gemarcano/soil_power_sensor/drawings/current.png

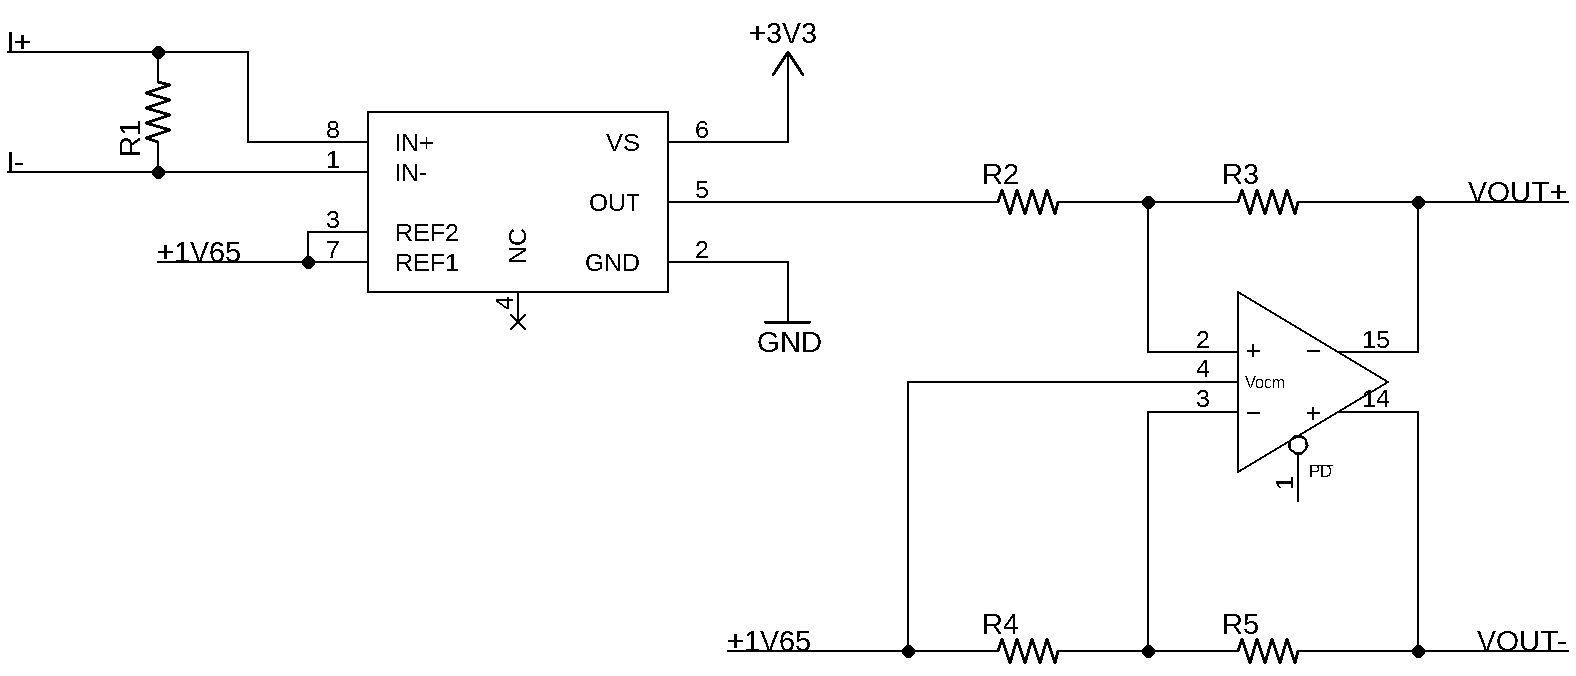
drawings/current.png
