gemarcano/soil_power_sensor/drawings/voltage.png

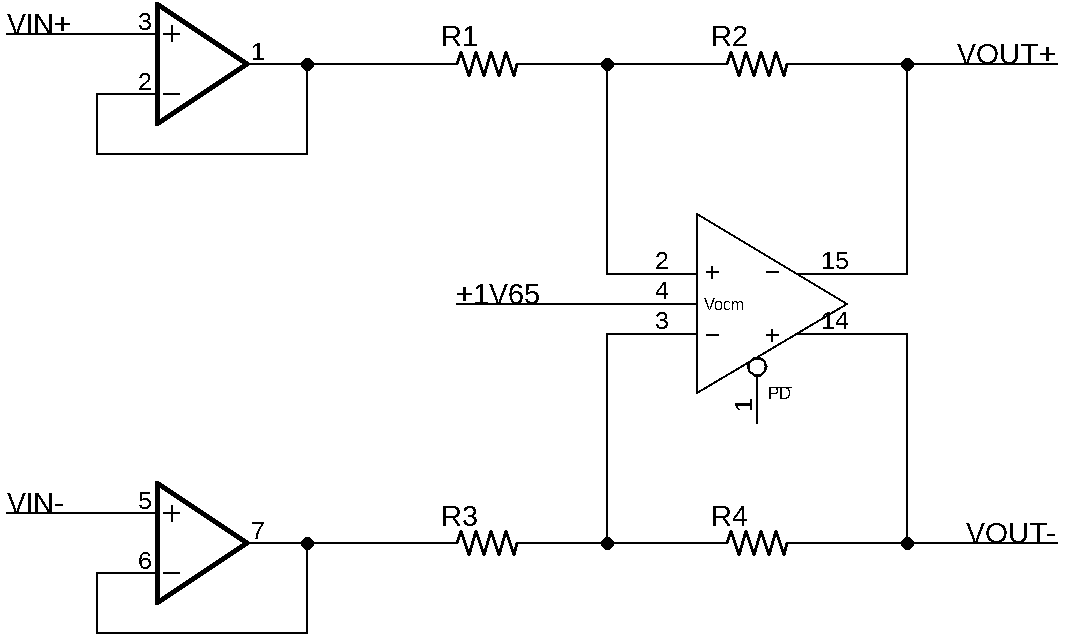
drawings/voltage.png
