gemarcano/soil_power_sensor/CHANGELOG.md

# Changelog

All notable changes to this project will be documented in this file.

The format is based on [Keep a Changelog](https://keepachangelog.com/en/1.0.0/), and this project adheres to [Semantic Versioning](https://semver.org/spec/v2.0.0.html).

## [Unreleased]

## [2.0.0-a.6] - 2023-05-10

### Schematic

- Updated current gain resistors

## [2.0.0-a.5] - 2023-05-02

### Schematic

- Removed buffer on negative rail and replaced MAX9944 with 
- Added values to parts missing VALUE text
- Renumbered all parts
- Remove power test points
- Added MPN to all passive components

### Board

- Iterate on board design
- Added UC Santa Cruz Logo
- Removed tValues
- Generated gerber files
- Updated low pass filter capacitance values
- Replaced 100nF capacitors with 0.1uF
- Replaced 250k resistors to 249K based on availability
- Replaced 0804 footprints with 0603

### Library

- Added MAX9943 device
- Added prefix for -3V3
- Updated LM27751 footprint
- Updated MAX9943 footprints

### Other

- Added source files for logos

## [2.0.0-a.4] - 2023-04-26

### Schematic

- Fixed duplicated naming for NRST net between STM32 and ESP32
- Fixed name of FSA2466 symbol
- Renamed differential pair nets to allow for differential pair routing
- Replaced Vcc on STM32 JTAG with +3V3

- Added experiment drawings

### Library

- Updated MAX9944 footprint
- Updated AAA55 Footprint

### Board

- Created initial layout for board

## [2.0.0-a.3] - 2023-04-11

### Schematic

- Removed jumper for 4th AAA battery cell
- Added document title and revision to frames
- Added TVS diode for both USB signal channels
- Fixed in-situ load connections
- Replaced FDA LTC6362 with THS4532IPW
- Moved multiplexer to analog signal side to reduce the number of ADCs as a cost saving measure
- Replaced low current main LDO TPS7A2033 with 1A TLV1117LV

- Replaced REF1933 with REF2033 due to availability
- Replaced TPS60403 with LM27761 due to availability

- Connected ESP32 EN pin to STM32 PA9 pin
- Connected STM32 PC0 to THS4532 PD pin
- Connected STM32 PC1 to EN on REF2033 and LM27761

### Library

- Verified footprints of all devices and fixed where applicable
- Added devices to Soil Power Sensor Library
	- TPD2E2U06DCKR
	- THS4532IPW
	- REF2033
	- LM27761
- Removed devices from Soil Power Sensor Library
	- MAX9918
	- LTC6362
	- STM32 Devices
	- Random oscillators
- Moved Wio-E5 to Soil Power Sensor library
- Defined attributes in CONTRIBUTING.md for efficient BOM generation

## [2.0.0-a.2] - 2023-03-14

### Added

- Added in-situ Rload
- Added connection for TEROS-12
- Added JTAG connection for STM32
- Added voltage monitoring circuit
- Added test points
- Added LP filter on signals leading to ADC
- Added FSA2466UMX to library
- Added Wifi Module (ESP32-C3)
- Added ESP32-C3-MINI-1-N4 to library
- Added TLV1117LV33DCYR to library
- Added battery with selectables jumpers
- Added AAA55
- Added Wio E5 and USB
- Added device MI0805K601R-10
- Added device MODULE_LORA_E5
- Added LT234XD-R device

### Fixed

- Fixed voltage and current connectors
- Fixed ADC interface with mux

### Changed

- Updated JTAG connector for ESP32
- Updated TLV1117LV33DCYR in library
- Moved power to seperate sheet

### Removed

None

## [2.0.0-a.1] - 2023-02-02

Initial design for Soil Power Sensor v2
