gemarcano/soil_power_sensor/Soil Power Sensor.pdf

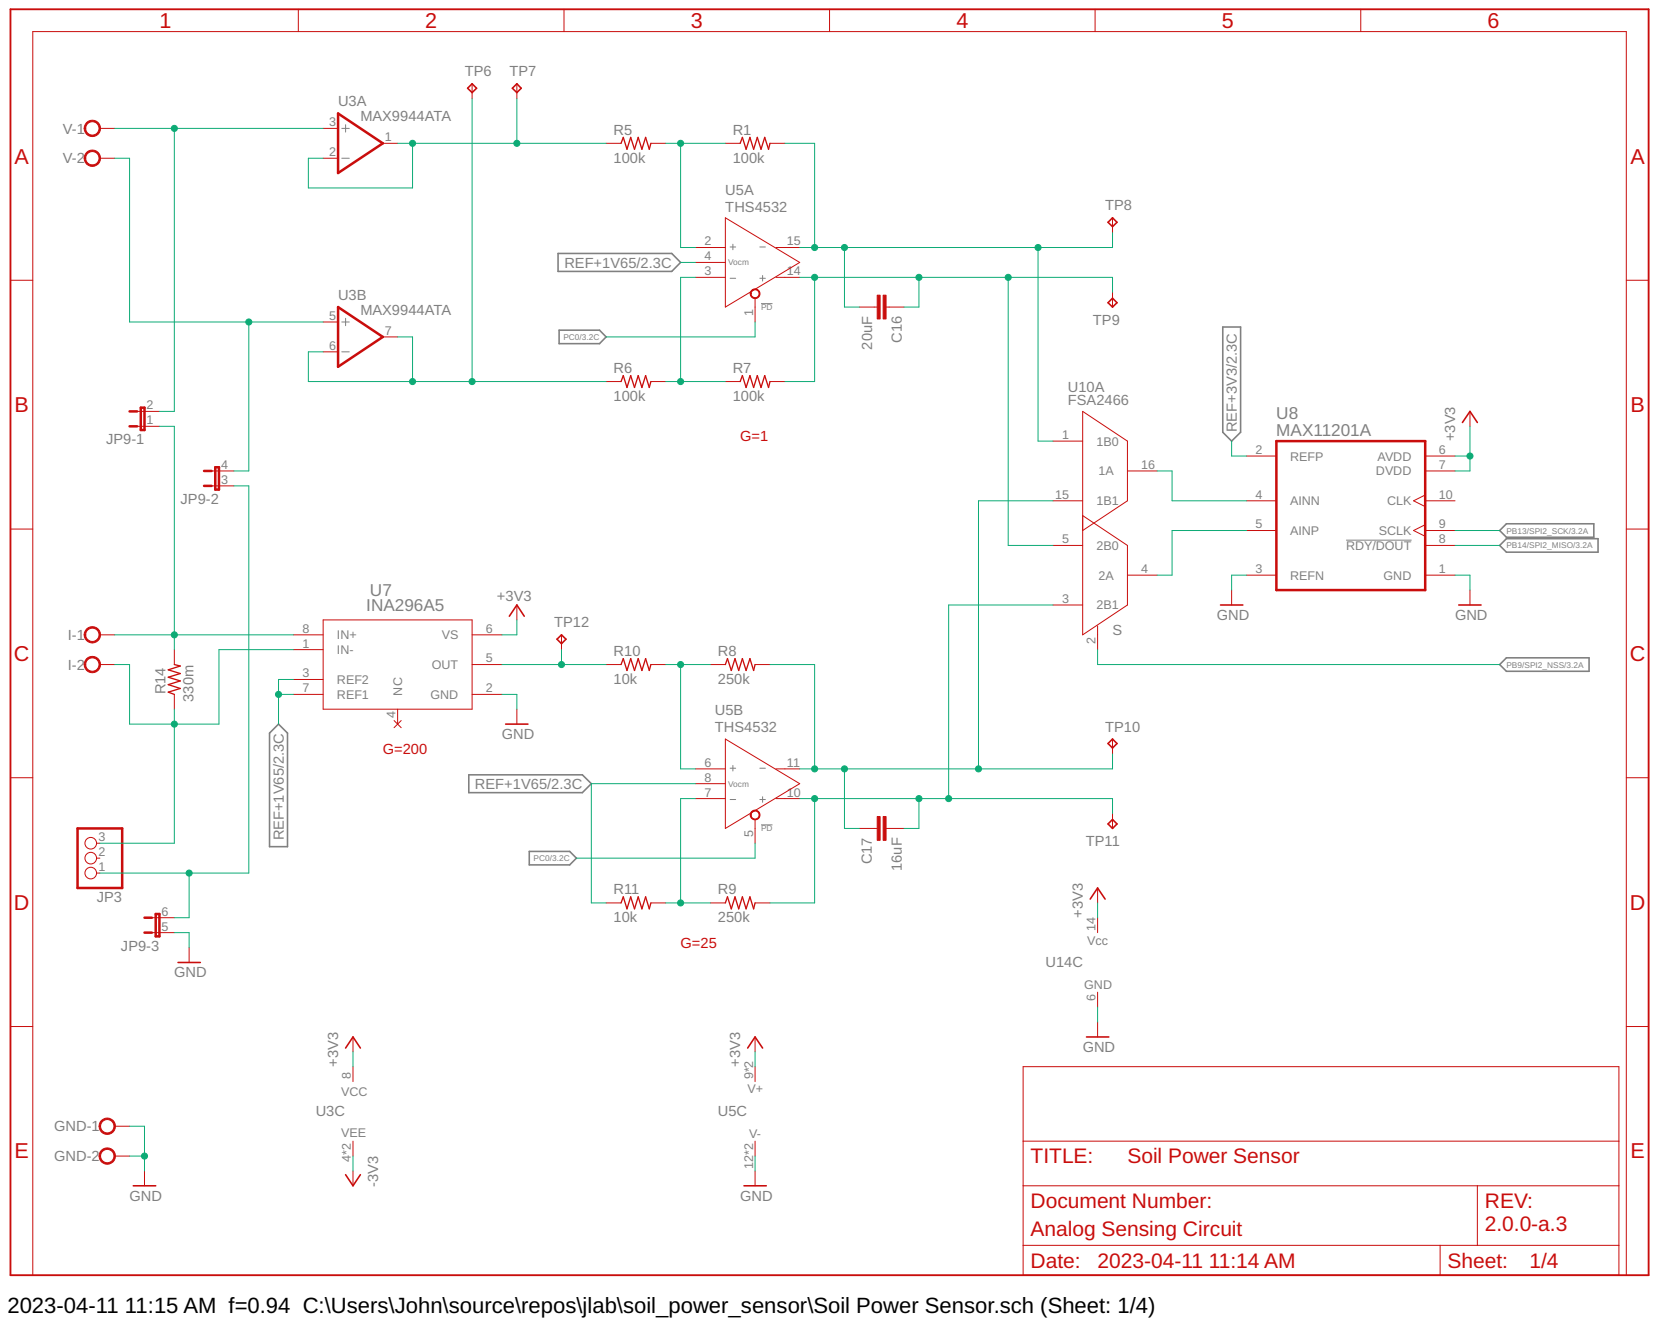
[picture p3: page 1]

2023-04-11 11:15 AM f=0.94 C:\Users\John\source\repos\jlab\soil_power_sensor\Soil Power Sensor.sch (Sheet: 1/4)

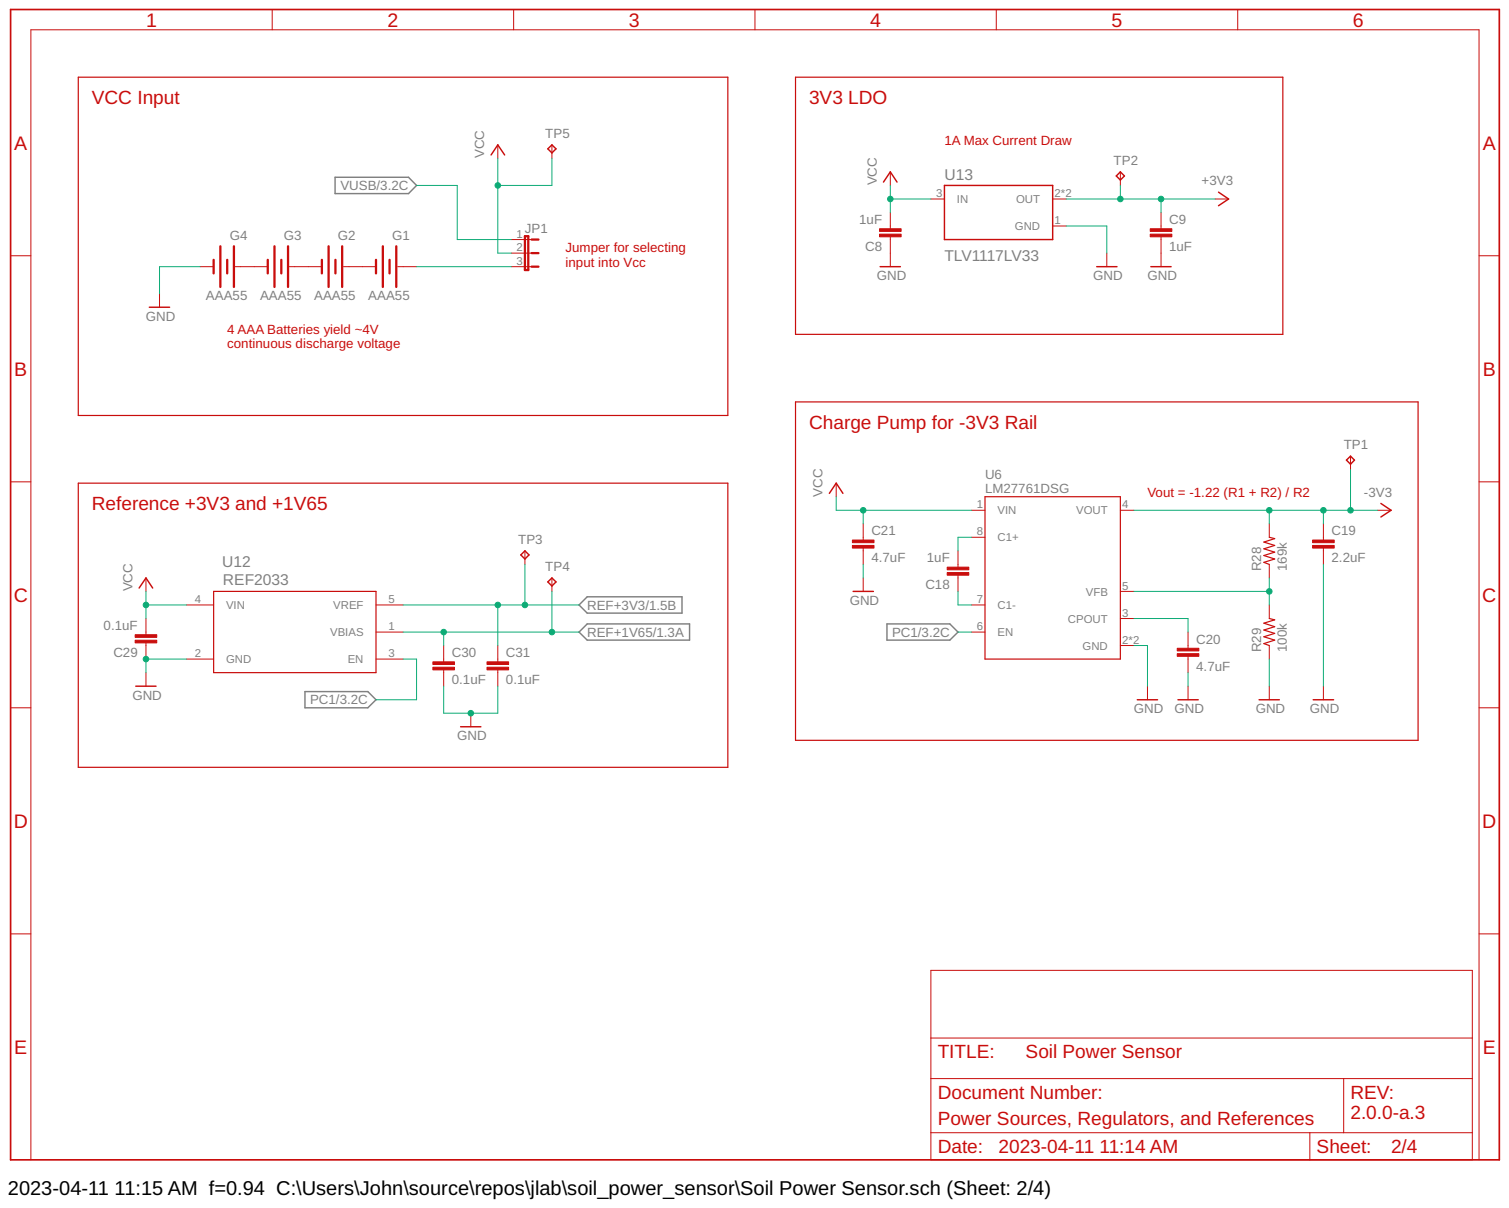
[picture p4: page 2]

1A Max Current Draw 3V3 LDO

input into Vcc 4 AAA Batteries yield ~4V

Charge Pump for -3V3 Rail

2023-04-11 11:15 AM f=0.94 C:\Users\John\source\repos\jlab\soil_power_sensor\Soil Power Sensor.sch (Sheet: 2/4)

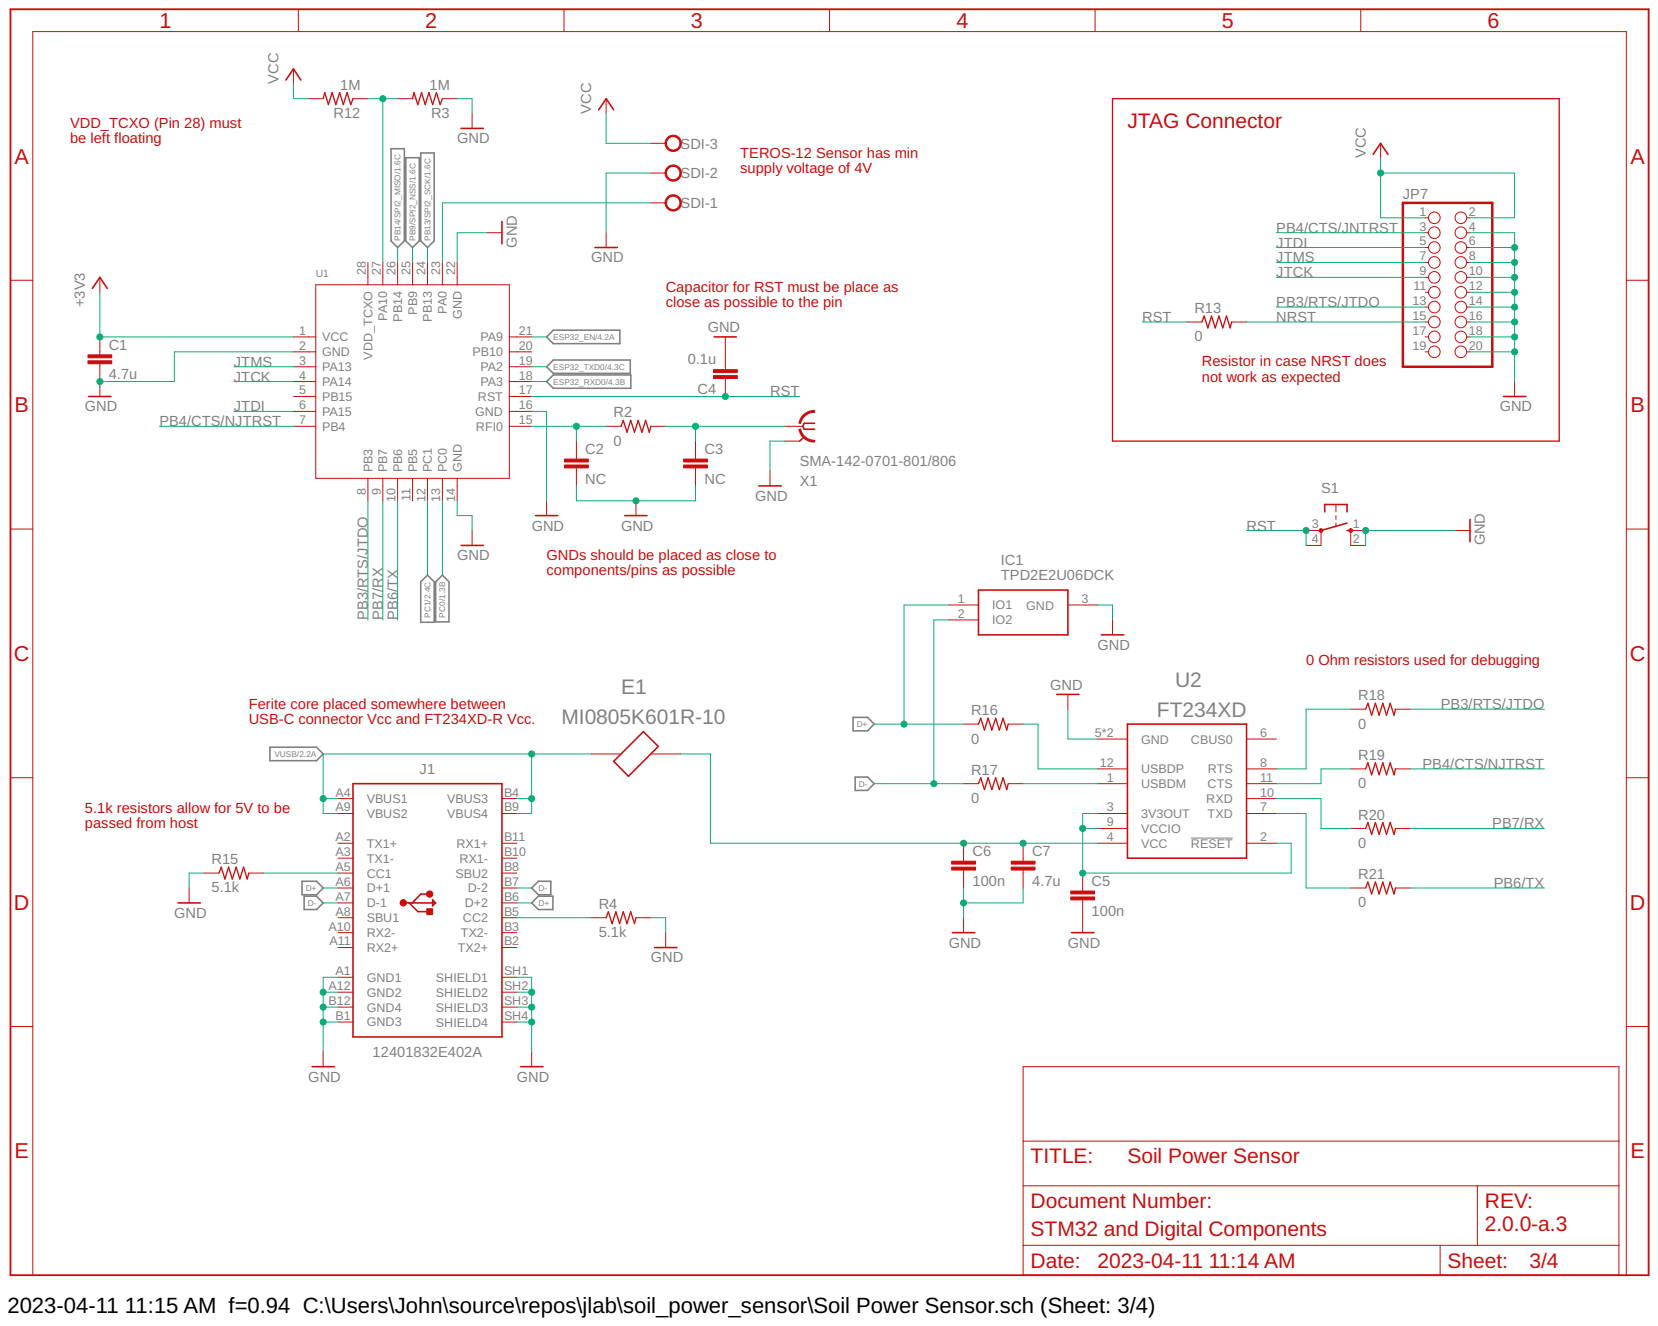
[picture p5: page 3]

VDD_TCXO (Pin 28) must be left floating

TEROS-12 Sensor has min
supply voltage of 4V

Capacitor for RST must be place as
close as possible to the pin

Resistor in case NRST does not work as expected

GNDs should be placed as close to
components/pins as possible

0 Ohm resistors used for debugging

Ferite core placed somewhere between USB-C connector Vcc and FT234XD-R Vcc. 5.1k resistors allow for 5V to be

2023-04-11 11:15 AM f=0.94 C:\Users\John\source\repos\jlab\soil_power_sensor\Soil Power Sensor.sch (Sheet: 3/4)

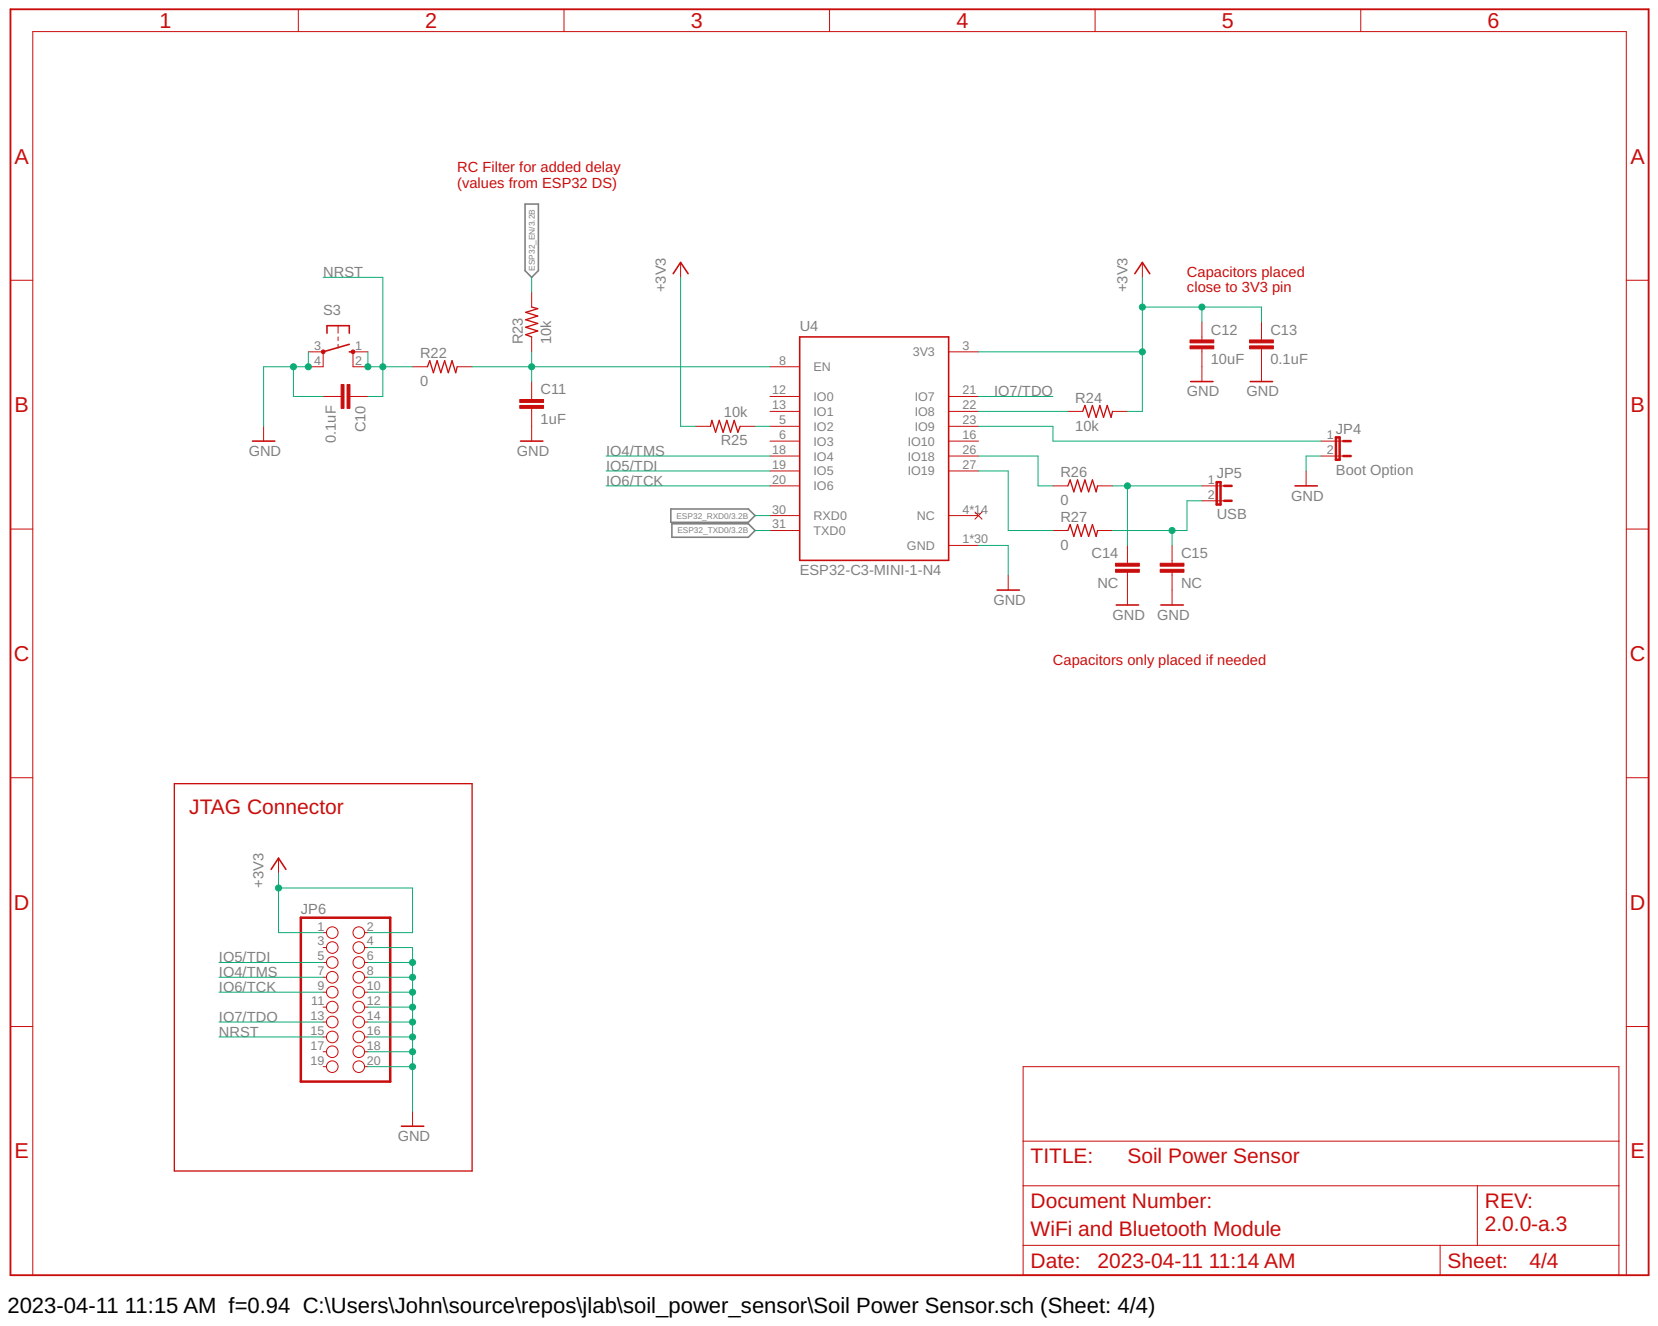
[picture p6: page 4]

ESP32_EN/3.2B RC Filter for added delay
(values from ESP32 DS)

Capacitors only placed if needed

JTAG Connector

2023-04-11 11:15 AM f=0.94 C:\Users\John\source\repos\jlab\soil_power_sensor\Soil Power Sensor.sch (Sheet: 4/4)
