gemarcano/soil_power_sensor/Power_Sensor_v65.pdf

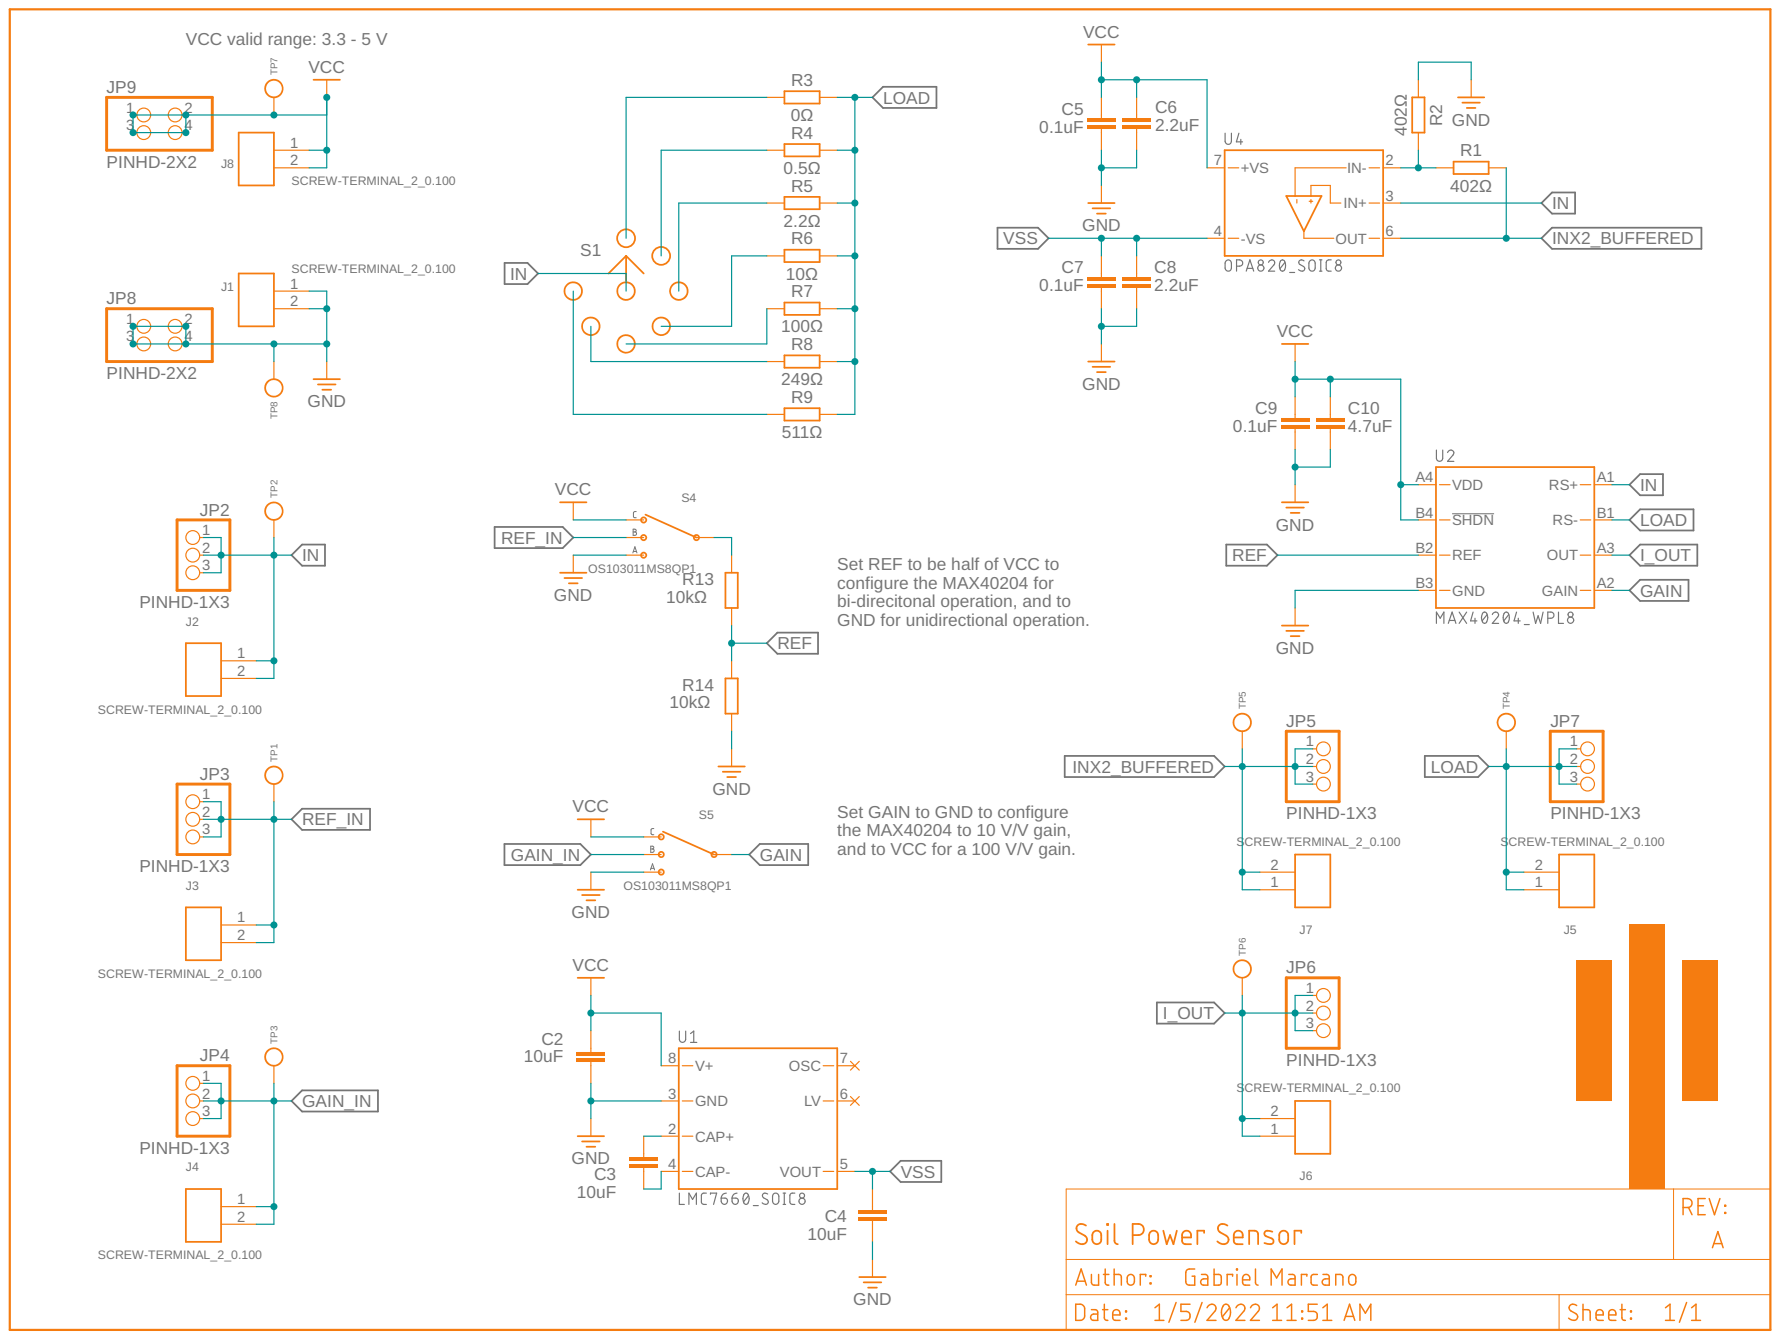
[picture p7: page 1]

Set REF to be half of VCC to
configure the MAX40204 for bi-direcitonal operation, and to GND for unidirectional operation.

Set GAIN to GND to configure
the MAX40204 to 10 V/V gain, and to VCC for a 100 V/V gain.
