gemarcano/soil_power_sensor/PCB_v112_std_top_bot.pdf

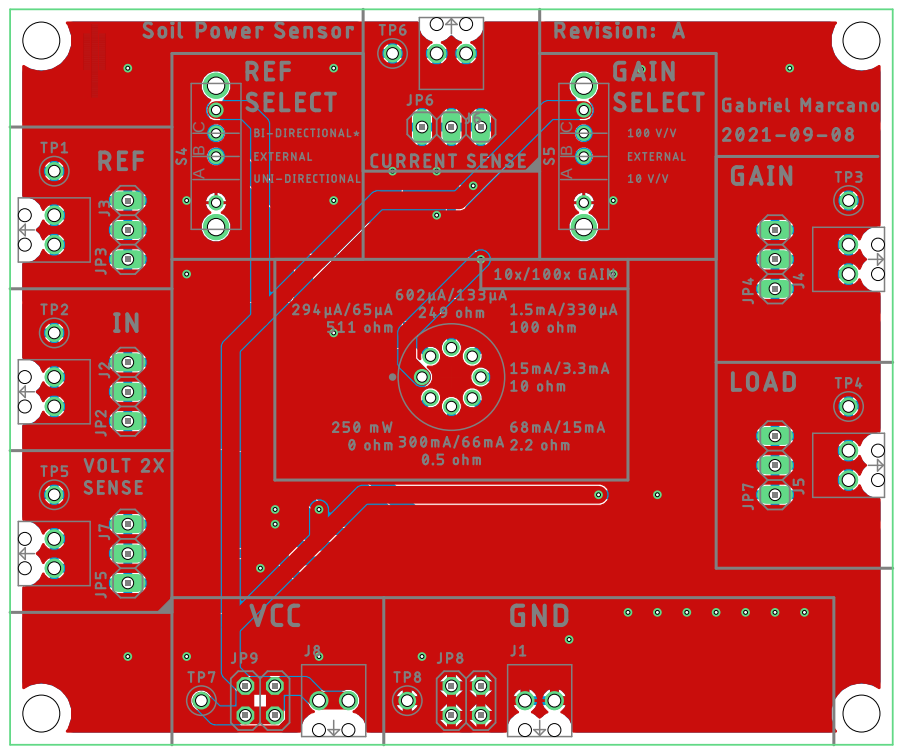
[picture p8: page 1]

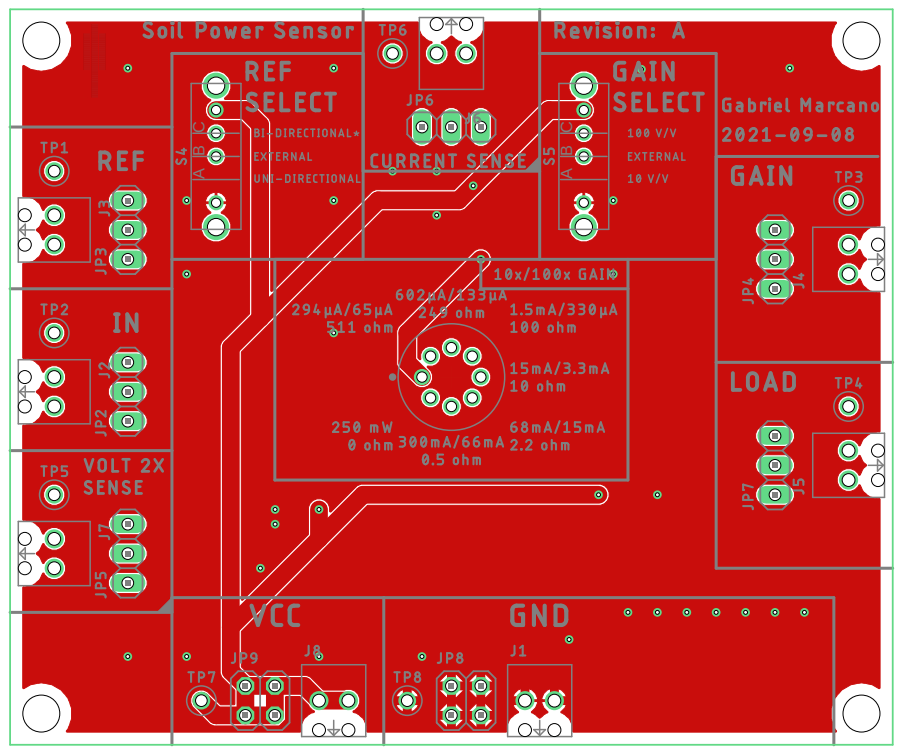
[picture p9: page 2]

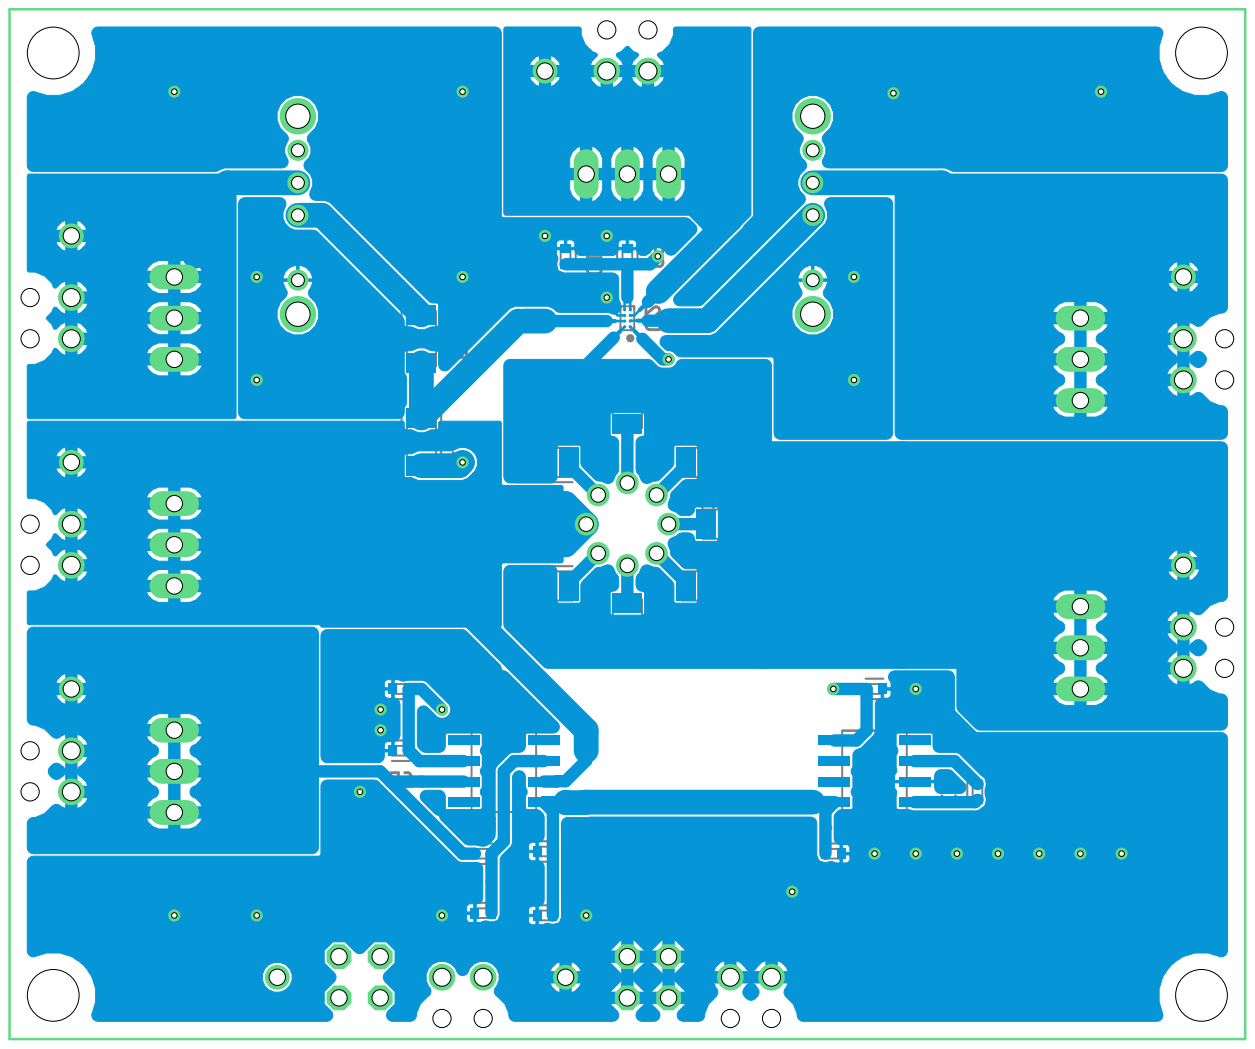
[picture p10: page 3]
