gemarcano/soil_power_sensor/(commit log)

2023-01-12 Moved design files to old/
    [PCB_v112.brd, Power_Sensor_v65.sch]
2023-01-23 Added STM32WLE5J8 library
2023-01-23 Added main Soil Power Sensor schematic
    [Soil Power Sensor.sch]
2023-01-23 Updatedl libraries
    [Soil Power Sensor.sch]
2023-01-31 Updated STM32WLE5J8I6 library
2023-01-31 Updated STM32WLE5C8U6 lib
2023-02-01 Updated LoRa schematic
    [Soil Power Sensor.sch]
2023-02-02 Added +/-3V3 sup circuits and Started sensing circuits
    [Soil Power Sensor.sch]
2023-02-02 Added ref voltages
    [Soil Power Sensor.sch]
2023-02-02 Completed sensing circuit
    [Soil Power Sensor.sch]
2023-02-02 Updated sensing circuit
    [Soil Power Sensor.sch]
2023-02-02 Added PDF of schematic
2023-03-05 Deleted STM32/Moved power to seperate sheet
    [Soil Power Sensor.sch]
2023-03-05 Added LT234XD-R device
2023-03-05 Added device MODULE_LORA_E5
2023-03-05 Added device MI0805K601R-10
2023-03-05 Added Wio E5 and USB
    [Soil Power Sensor.sch]
2023-03-07 Added battery with selectables jumpers
    [Soil Power Sensor.sch]
2023-03-08 Added ESP32-C3-MINI-1-N4 to library
2023-03-08 Added Wifi Module (ESP32-C3)
    [Soil Power Sensor.sch]
2023-03-09 Fixed ADC interface with mux
    [Soil Power Sensor.sch]
2023-03-09 Fixed voltage and current connectors
    [Soil Power Sensor.sch]
2023-03-10 Added LP filter on signals leading to ADC
    [Soil Power Sensor.sch]
2023-03-10 Added test points
    [Soil Power Sensor.sch]
2023-03-11 Added voltage monitoring circuit
    [Soil Power Sensor.sch]
2023-03-15 Added JTAG connection for STM32
    [Soil Power Sensor.sch]
2023-03-15 Updated JTAG connector for ESP32
    [Soil Power Sensor.sch]
2023-03-15 Added connection for TEROS-12
    [Soil Power Sensor.sch]
2023-03-15 Added in-situ Rload
    [Soil Power Sensor.sch]
2023-03-15 Updated pdf schematic
2023-03-28 Removed 4th battery jumper
    [Soil Power Sensor.sch]
2023-03-28 Added jumper for selecting supply for ESP32
    [Soil Power Sensor.sch]
2023-03-28 Fixed in-situ load connections
    [Soil Power Sensor.sch]
2023-03-29 Changed frames to include doc title and rev
    [Soil Power Sensor.sch]
2023-03-29 Added device TPD2E2U06DCKR
2023-03-29 Added TVS diode on USB connector
    [Soil Power Sensor.sch]
2023-04-04 Added devicee THS4532IPW
2023-04-04 Added drawings of current and voltage sensing circuits
    [current.sch, voltage.sch]
2023-04-04 Updated device THS4532IPW
2023-04-04 Replaced LTC6362 with THS4532IPW
    [Soil Power Sensor.sch]
2023-04-05 Updated device AAA55
2023-04-05 Updated device ESDALC6V1-1U2
2023-04-05 Updated device ESP32-C3-MINI-1-N4
2023-04-05 Added ref to device ESDALC6V1-1U2
2023-04-05 Updated device FSA2466
2023-04-05 Updated device FT234XD
2023-04-05 Updated device INA293
2023-04-05 Updated device INA296
2023-04-05 Updated MPN for device INA293
2023-04-06 Updated device LMP2232
2023-04-06 Removed STM32 devices
2023-04-06 Removed device LTC6362
2023-04-06 Removed device MAX9918
2023-04-06 Updated device MAX9944
2023-04-06 Updated MAX1120* devices
2023-04-06 Updated device MI0805K601R-10
2023-04-07 Updated device REF1933
2023-04-07 Updated device THS4532
2023-04-07 Updated device TLV1117LV
2023-04-07 Updated device TPD2E2U06
2023-04-07 Updated device TPS7A20
2023-04-07 Updated device TPS6040X
2023-04-11 Replaced old devices with updated versions
    [Soil Power Sensor.sch]
2023-04-11 Updated MAX1120* symbol
    [Soil Power Sensor.sch]
2023-04-11 Moved Wio-E5 module to SPS library
    [Soil Power Sensor.sch]
2023-04-11 Updated device TPS7A20*P attributes
    [Soil Power Sensor.sch]
2023-04-11 Moved mux to analog signals
    [Soil Power Sensor.sch]
2023-04-11 Replaced low current LDO with 1A LDO
    [Soil Power Sensor.sch]
2023-04-11 Connected STM32 PA9 to ESP32 EN pin
    [Soil Power Sensor.sch]
2023-04-11 Connect STM32 PC0 to THS4532 PD pin
    [Soil Power Sensor.sch]
2023-04-11 Replaced TPS60403 with LM27761
    [Soil Power Sensor.sch]
2023-04-11 Updated pins of LM27761
    [Soil Power Sensor.sch]
2023-04-11 Replaced REF1933 with in-stock REF2033
    [Soil Power Sensor.sch]
2023-04-11 Connected EN on REF2033 and LM27761 to Wio-E5
    [Soil Power Sensor.sch]
2023-04-11 Added BOM
    [Soil Power Sensor.csv]
2023-04-11 Version bumped schematic
    [Soil Power Sensor.sch]
2023-04-11 Updated schematic PDF
2023-04-15 Added Soil Power Sensor.brd
    [Soil Power Sensor.brd]
2023-04-15 Added design rules for jlcpb 4-layer board
2023-04-17 Updated MAX9944 footprint
2023-04-20 Initial commit of board layout
    [Soil Power Sensor.brd, Soil Power Sensor.sch]
2023-04-26 Updated board
    [Soil Power Sensor.brd]
2023-04-26 Added experiment drawings
    [experiment double buffer grounded.sch, experiment double buffer.sch, experiment single buffer grounded.sch, experiment single buffer.sch]
2023-04-27 Added MAX9943 device
2023-04-27 Removed V- buffer and replaced MAX9944 with MAX9943
    [Soil Power Sensor.brd, Soil Power Sensor.sch]
2023-04-27 Added values to parts missing it
    [Soil Power Sensor.brd, Soil Power Sensor.sch]
2023-04-27 Reset board layout
    [Soil Power Sensor.brd]
2023-04-27 Renumbered all parts
    [Soil Power Sensor.brd, Soil Power Sensor.sch]
2023-04-27 Updated LM27751 footprint
2023-04-27 Updated MAX9943 footprint
2023-04-29 Redesigned board
    [Soil Power Sensor.brd, Soil Power Sensor.sch]
2023-04-30 Added slug logo
    [Soil Power Sensor.brd]
2023-05-01 Fixed DRC errors
    [Soil Power Sensor.brd]
2023-05-01 Replaced all 0402 components with 0603
    [Soil Power Sensor.brd, Soil Power Sensor.sch]
2023-05-02 Added pos, neg symbols for voltage con
    [Soil Power Sensor.brd]
2023-05-02 Updated spacing of logo
    [Soil Power Sensor.brd]
2023-05-02 Removed old folder
    [PCB_v112.brd, Power_Sensor_v65.sch]
2023-05-02 Version bumped schematic to 2.0.0-a.5
    [Soil Power Sensor.sch]
2023-05-02 Generated jlcpcb gerber files
2023-05-02 Updated consistent naming for components
    [Soil Power Sensor.brd, Soil Power Sensor.sch]
2023-05-02 Added MPN to passive components
    [Soil Power Sensor.brd, Soil Power Sensor.sch]
2023-05-02 Initial commit of optimal low pass filter code
2023-05-02 Updated BOM
    [Soil Power Sensor.csv]
2023-05-02 Updated gerber files
2023-05-11 Updated current sensing gains
    [Soil Power Sensor.brd, Soil Power Sensor.sch]
2023-05-11 Version bumped to 2.0.0-a.6
    [Soil Power Sensor.brd, Soil Power Sensor.csv, Soil Power Sensor.sch]
