gemarcano/soil_power_sensor/(notices)

Notices in the files:
parts and their libraries:
Soil Power Sensor: COPYRIGHT: Copyright (C) 2023 Ultra Librarian. All rights reserved.
